gimmepizza/Roled-display-itsp-iitb/README.md

# RoLED-Display
#beni madhav agrawal,yash shah(ys1998), sarthak mallick
Image Processing code and Arduino Sketch for Rotating LED Display project

Keep the directory structure intact.
For running the program, install all the required libraries as shown:
```
./install-opencv.sh
pip install pybluez
```
and then execute the bash script using:
```
bash roled.sh
```
