gimmepizza/Roled-display-itsp-iitb/bm_res.png

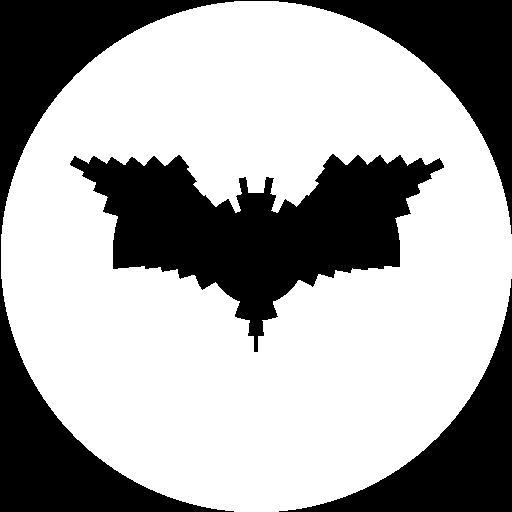
bm_res.png
