gimmepizza/Roled-display-itsp-iitb/crown.jpg

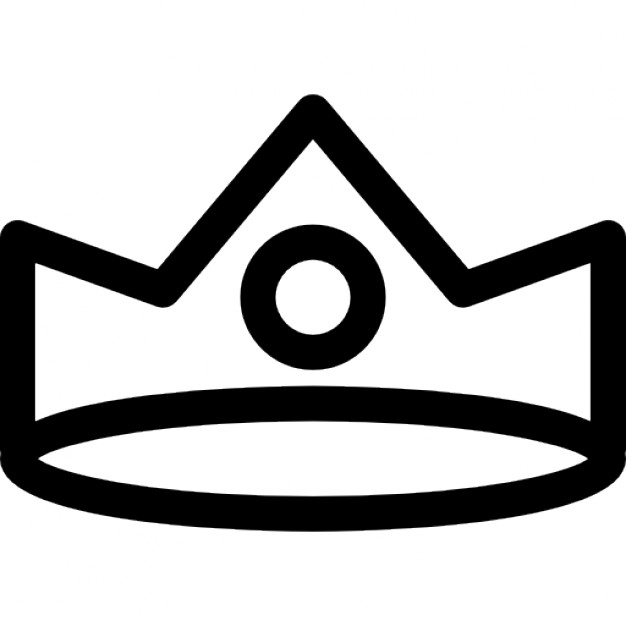
crown.jpg
