gimmepizza/Roled-display-itsp-iitb/dh.jpg

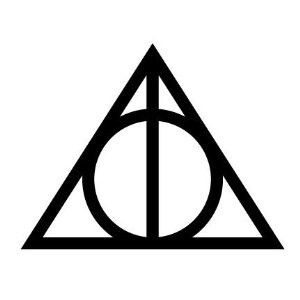
dh.jpg
