gimmepizza/Roled-display-itsp-iitb/heart.jpg

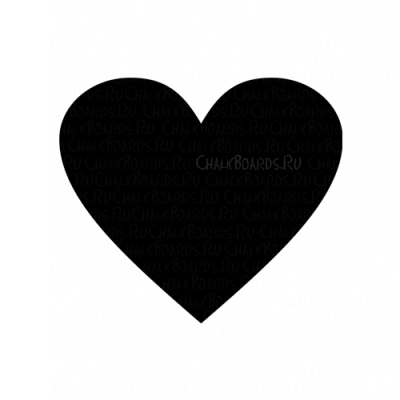
heart.jpg
