gimmepizza/Roled-display-itsp-iitb/smiley.jpeg

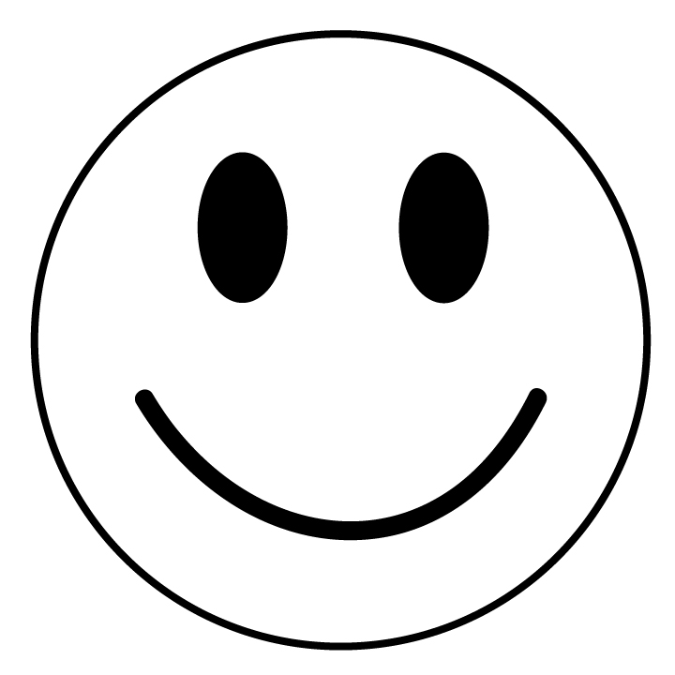
smiley.jpeg
