gimmepizza/Roled-display-itsp-iitb/text_res.png

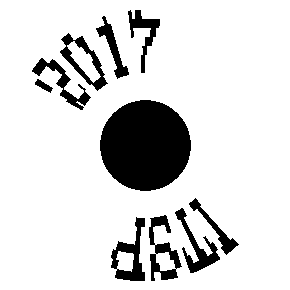
text_res.png
