gimmepizza/Roled-display-itsp-iitb/bluetooth_tester.ino

void setup() {
  // put your setup code here, to run once:
  Serial.begin(9600);
  while(!Serial){;}
}

void loop() {
  // put your main code here, to run repeatedly:
  if(Serial.available())
  {
    char data=Serial.read();
    Serial.println(data);
  }

}
