gimmepizza/Roled-display-itsp-iitb/(commit log)

2017-06-04 Initial arduino sketch
2017-06-04 Arduino bluetooth-tester sketch
2017-06-04 Sample images/text
